Suraj-221/cad/Complete Assembly.SLDASM

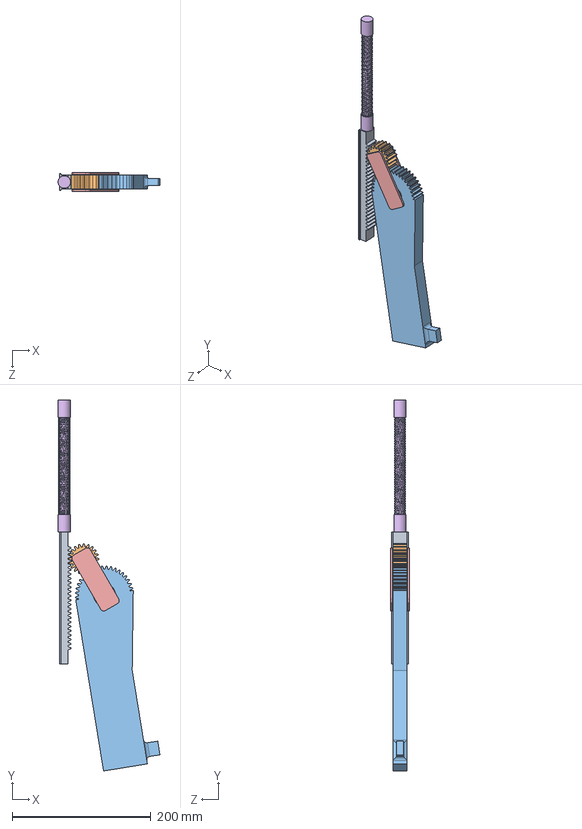
[picture p16: CAD file, 2026-10-20]
Complete Assembly.SLDASM
146.9 x 534.5 x 28.0 mm
Rack
spur gear 40mm
spur gear_arm
instrument ball bearing_68_am x 2
Connector
McK
