Suraj-221/cad/Rack.SLDPRT

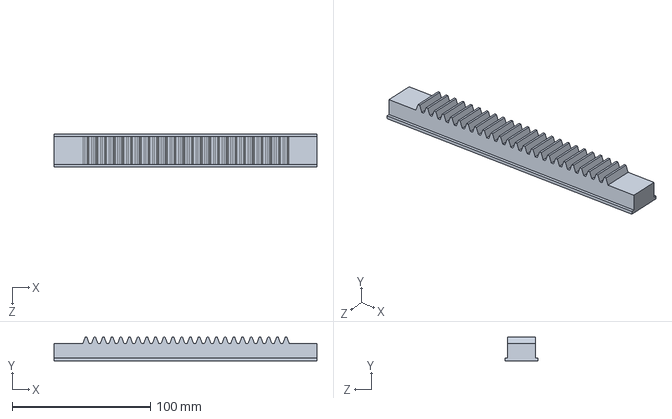
[picture p17: CAD file, 2026-10-20]
Rack.SLDPRT
190.0 x 17.0 x 24.0 mm
