Suraj-221/cad/Guide.SLDPRT

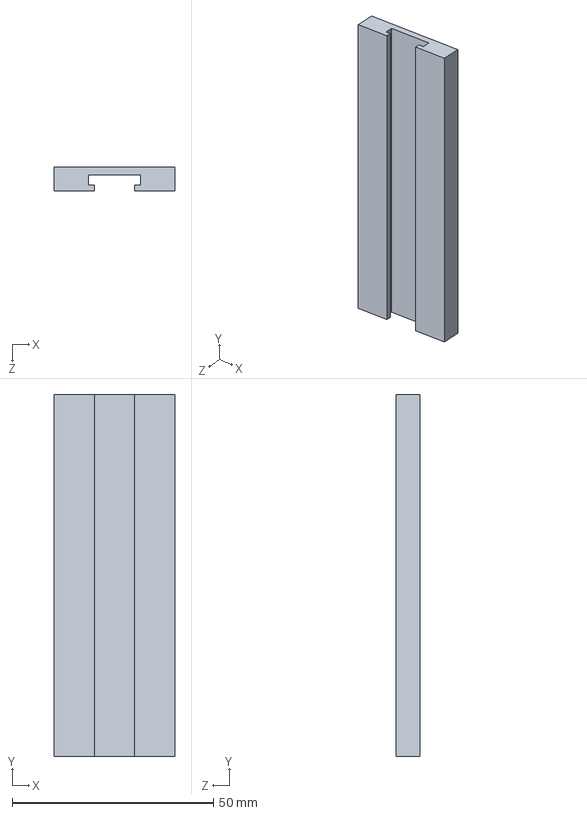
[picture p18: CAD file, 2026-10-20]
Guide.SLDPRT
30.0 x 90.0 x 6.00 mm
