Suraj-221/cad/spur gear 40mm.SLDPRT

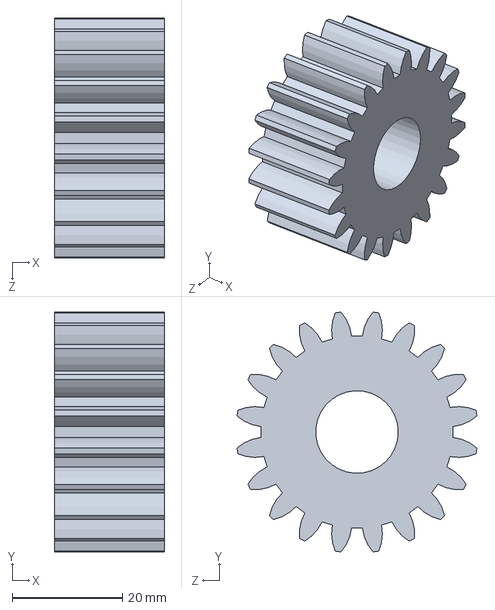
[picture p19: CAD file, 2026-10-20]
spur gear 40mm.SLDPRT
20.0 x 43.6 x 43.6 mm
