Suraj-221/cad/spur gear_arm.SLDPRT

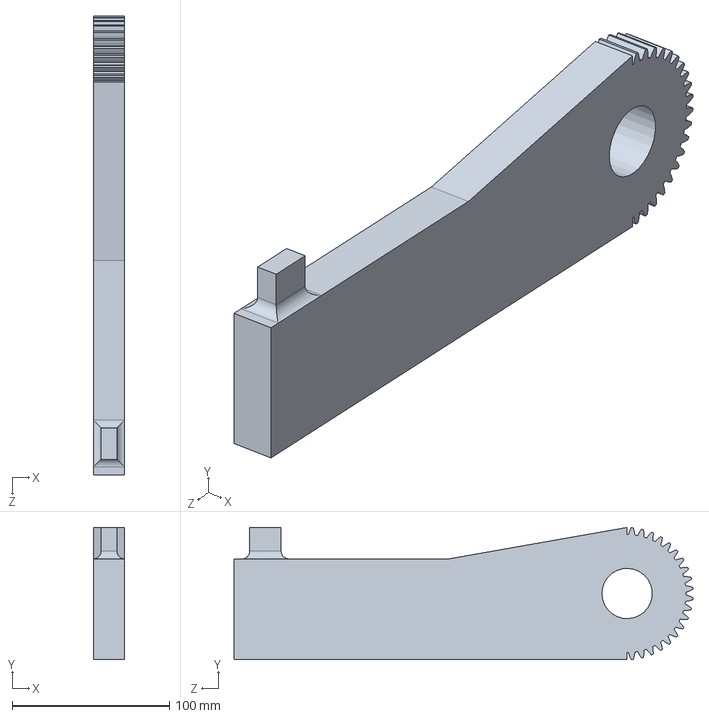
[picture p20: CAD file, 2026-10-20]
spur gear_arm.SLDPRT
20.0 x 84.0 x 291.9 mm
