Suraj-221/cad/McK.SLDPRT

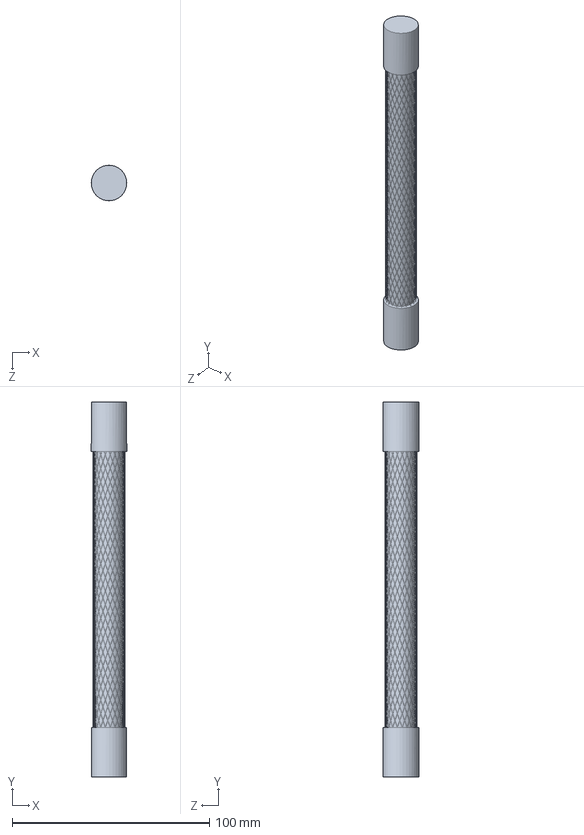
[picture p21: CAD file, 2026-10-20]
McK.SLDPRT
18.0 x 190.0 x 18.0 mm
