Suraj-221/cad/Upper arm.SLDPRT

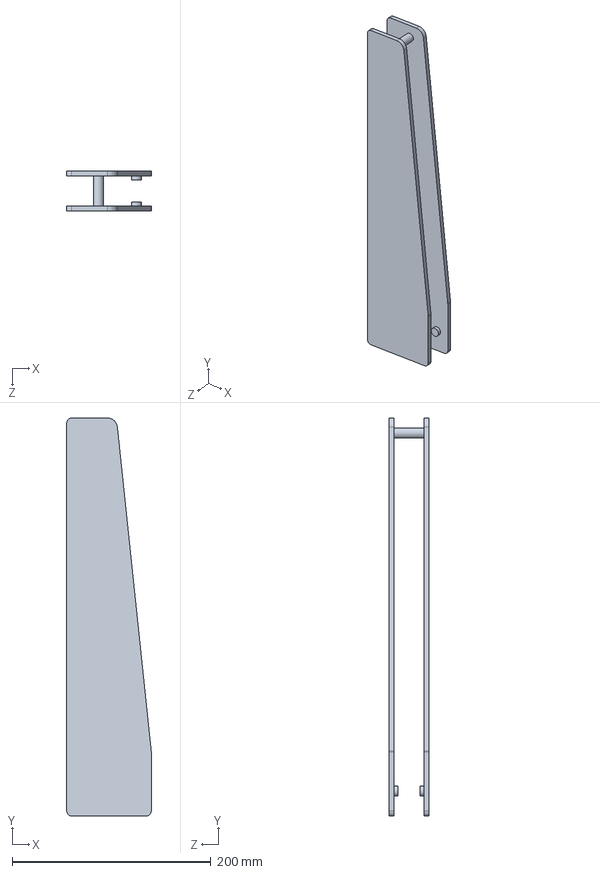
[picture p22: CAD file, 2026-10-20]
Upper arm.SLDPRT
85.0 x 400.0 x 40.0 mm
