Suraj-221/cad/Connector.SLDPRT

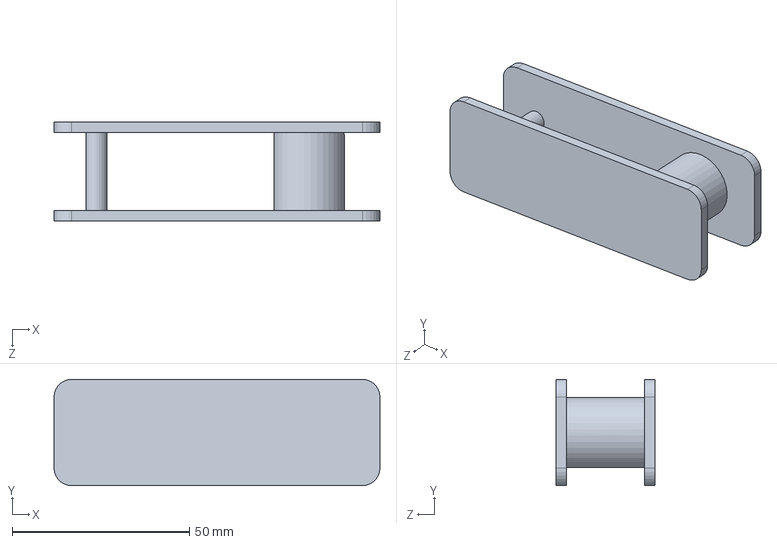
[picture p23: CAD file, 2026-10-20]
Connector.SLDPRT
92.0 x 30.0 x 28.0 mm
